docvacuumtubes/Sequencer/README.md

# Sequencer
Construction and operating information for a ham radio sequencer (for transmit/receive transitions)
