docvacuumtubes/Sequencer/SchemticV0.2.pdf

Sequencer V0.2
12/29/2025

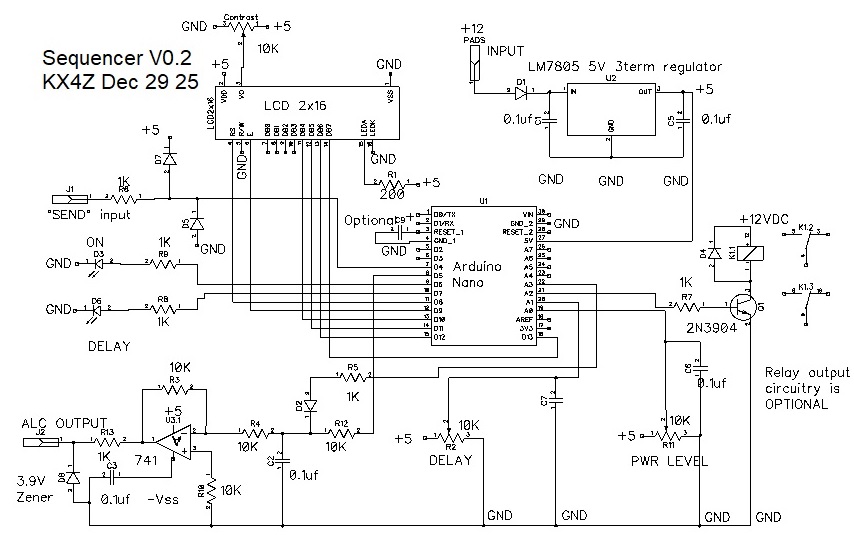
[picture p6: figure]
