docvacuumtubes/Sequencer/satellitesequencerbox.3mf

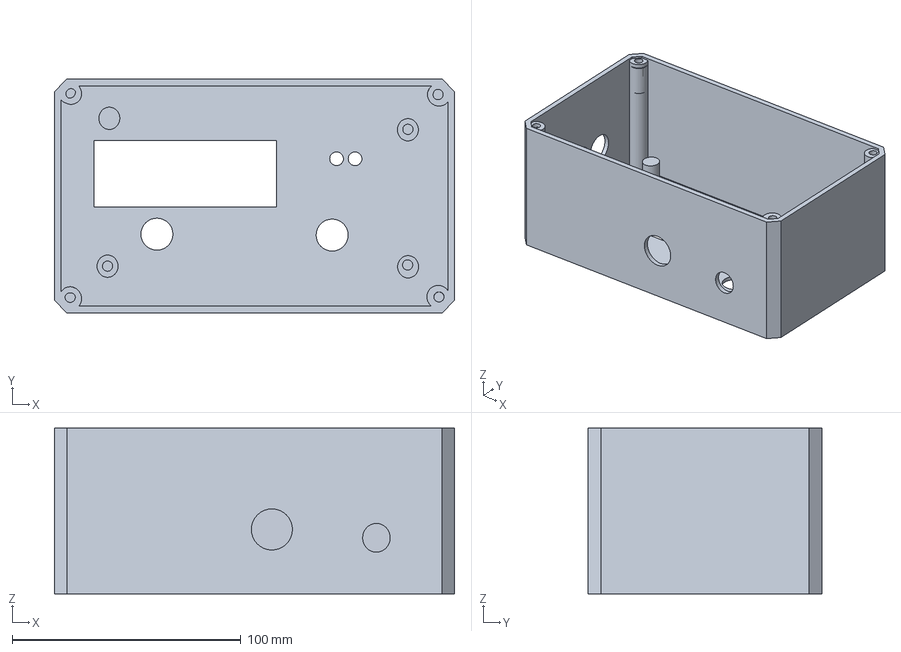
[picture p7: CAD file, 2025-12-30]
satellitesequencerbox.3mf
175.0 x 102.5 x 72.5 mm
