docvacuumtubes/Sequencer/satellitesequencerbottomflanged.stl

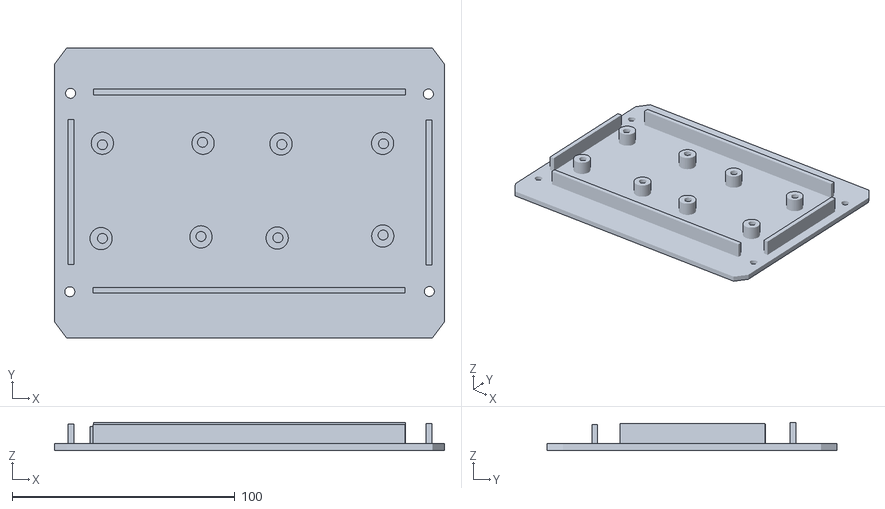
[picture p8: CAD file, 2025-12-30]
satellitesequencerbottomflanged.stl
175.0 x 130.0 x 12.6
