docvacuumtubes/Sequencer/(list of files, cad)

Other CAD files:
satellitesequencerbox.stl
