docvacuumtubes/Sequencer/(commit log)

2025-12-30 Arduino Nano Sketch Ver 0.2
    Working software
2025-12-30 PDF of V0.2 schematic
2025-12-30 Main Box
    Bambu Studio said this needed "repairing" and it was able to do that and then print successfully!
    [satellitesequencerbox.stl]
2025-12-30 Satellite box BASE
    You'll need to put some "feet" to keep the screws from scratching surfaces
    [satellitesequencerbottomflanged.stl]
2025-12-30 Bambu Studio project file for basic box
    An alternative to the STL file if you have Bambu Studio
    [satellitesequencerbox.3mf]
