docvacuumtubes/Sequencer/(notices)

Notices in the files:
SatelliteSequencerVer0.2.ino:
GNU General Public License 3.0
This program is free software: you can redistribute it and/or modify
it under the terms of the GNU General Public License as published by
the Free Software Foundation, version 3 of the License.
